AngrySaltyFish24/ServerController/README.md

# ServerController

This project allows for a server to be remotely turned on and off using a particle photon board along with a series of relays.
