AngrySaltyFish24/ServerController/EPQ – Artefact.pptx

## EPQ – Artefact Server Controller

By James Rand

## The main aim of the project

- File server that is used to store work
- Sever cannot always be on.
- I always want to have access to the server.
- Build a device that can remotely turn on and off the server.

## Checklist

- Be able to turn the server on and off
- Be power efficient to avoid cost
- Forward a shell to the server
- Have an interface to perform all of the tasks above
- Do not exceed the budget of £50.00

## Choosing the components

- Need a development board that can connect to WiFi
  - Raspberry pi
  - Photon
- Electronic switches that can be controlled by the board
  - Relays
  - Transistors

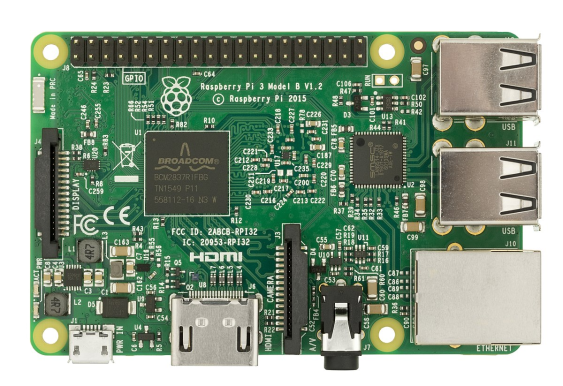
[picture p23: figure]
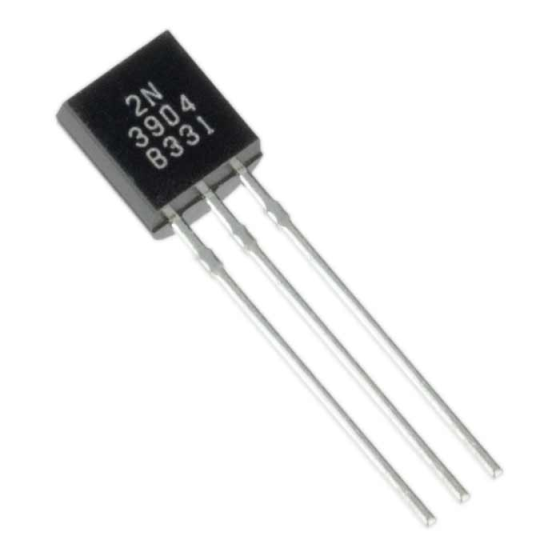
[picture p24: figure]
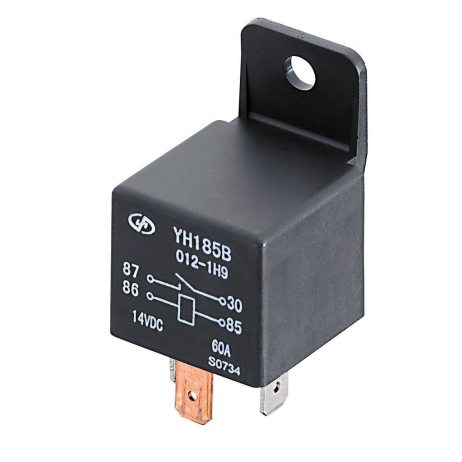
[picture p25: figure]

## The particle photon

- Pros
  - Relatively cheap
  - Has extensive api to help program
  - Draws little power
  - Good documentation
- Cons
  - Does not have an OS to interact with
  - Limited functionality

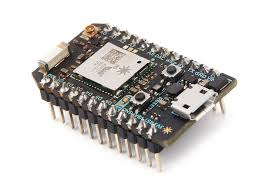
[picture p26: figure]

## Relay board

- Pros
  - Can handle high voltages with ease
  - Detachable
  - Easy to use
  - Expandable
- Cons
  - Expensive

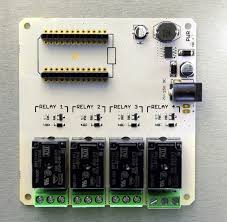
[picture p27: figure]

## Design for turning on the server

These wires go to the
Particle photon

Relay

## Stopping standby to save more power

Wires to controller

## Adding a override switch

- Decided to add a switch
- Stops any attempts to turn
on the server

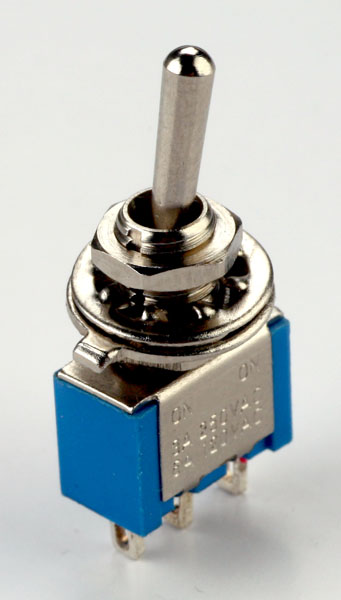
[picture p28: figure]

## An interesting Quirk

- Usb port is only powered when the server is on
- Use this power to turn off the controller using another relay

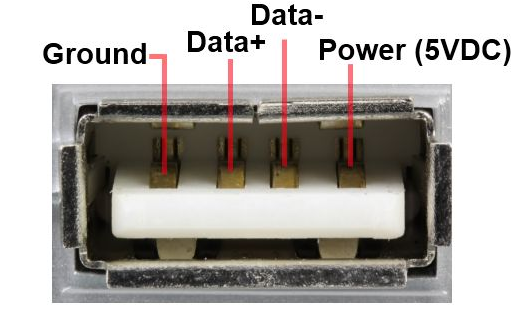
[picture p29: figure]

## Code

- An interface in python
- Code on the controller written in C
- Also using the api for the controller code

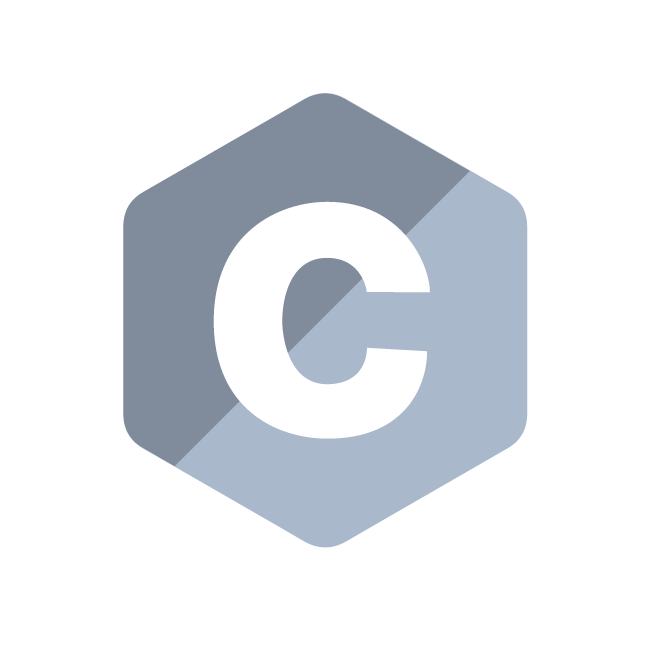
[picture p30: figure]
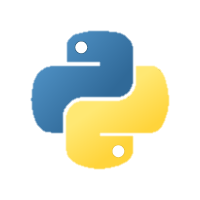
[picture p31: figure]

## Controller code

- Saves the ip address
- Activates the relays

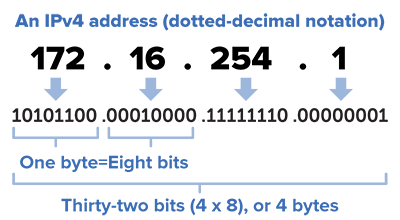
[picture p32: figure]
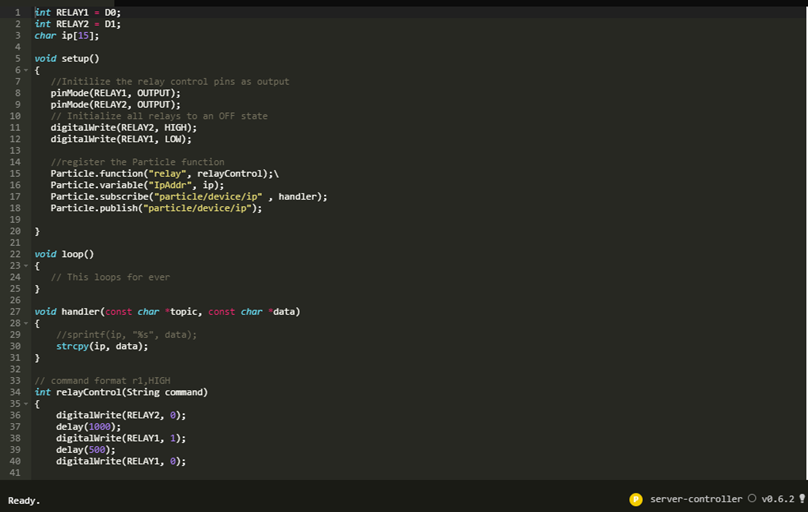
[picture p33: figure]

## Python interface

- Send the request to turn on the server
- Get the ip address from controller
- Use that ip address to open ssh connection

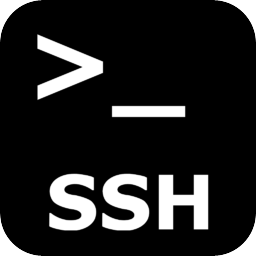
[picture p34: figure]
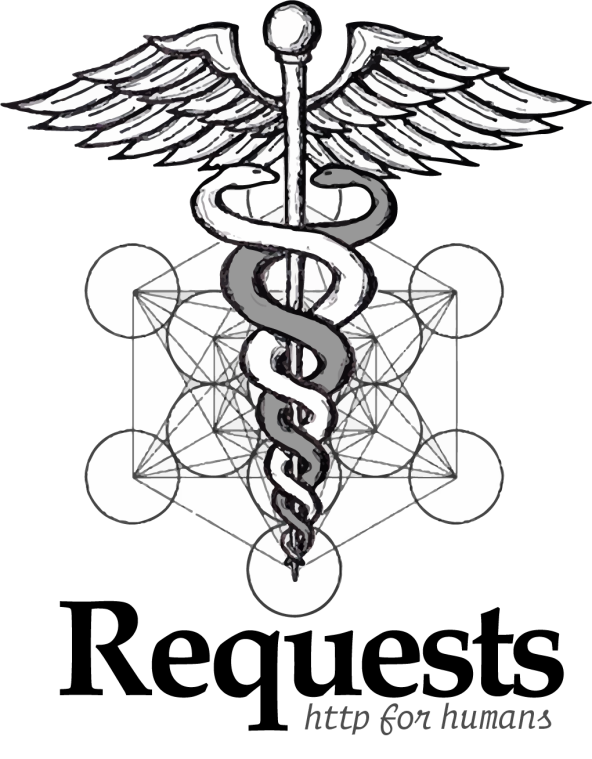
[picture p35: figure]

## Putting it all together

- Processes used
  - Soldering
- Materials used
  - solder
  - Electrical tape

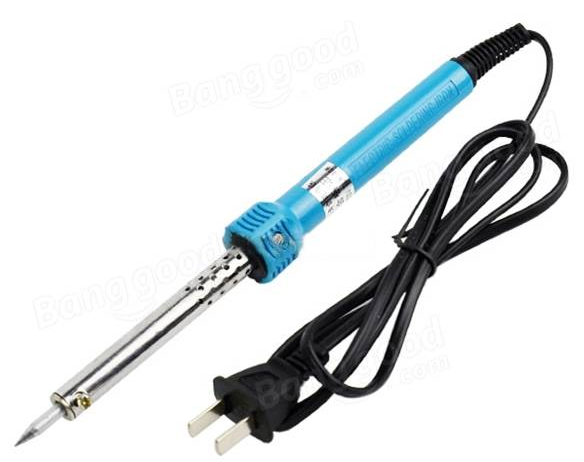
[picture p36: figure]
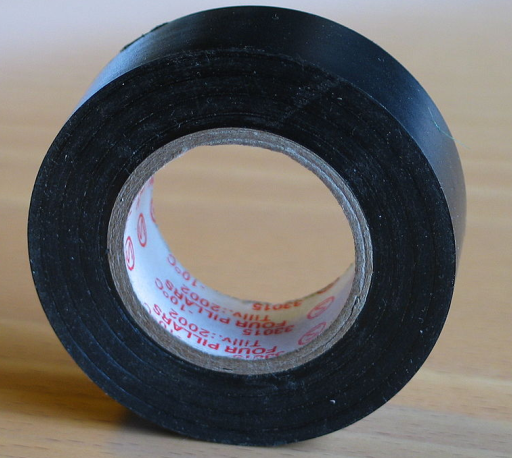
[picture p37: figure]
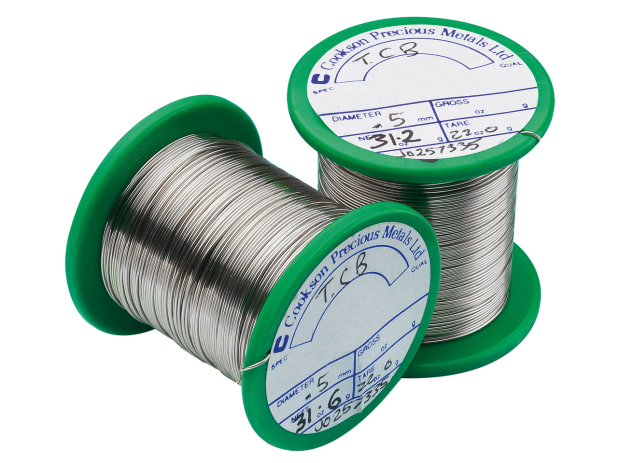
[picture p38: figure]

## Evaluation

- What went well
  - Turns on the server
  - Uses very little power
- What went poorly
  - The python interface is buggy and unstable
    - This could be improve without time constraints
    - Could have ported the interface to a bot so many users could interact with it

## What I’ve Learnt

- Learnt about different electronic components and how they work
