AngrySaltyFish24/ServerController/docs/pictures/camera/externalRelayTest.jpg

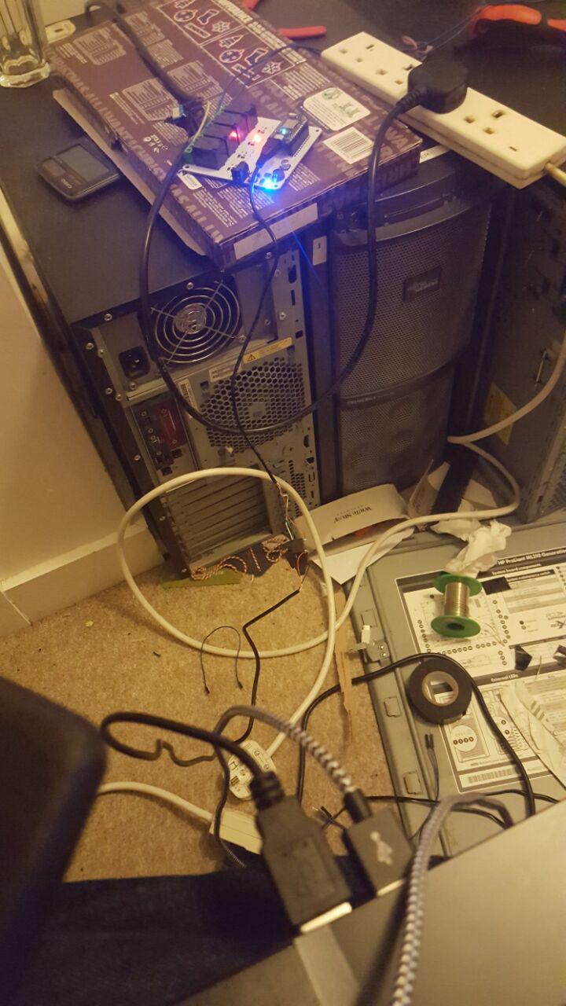
docs/pictures/camera/externalRelayTest.jpg
