AngrySaltyFish24/ServerController/docs/pictures/transistorTest.PNG

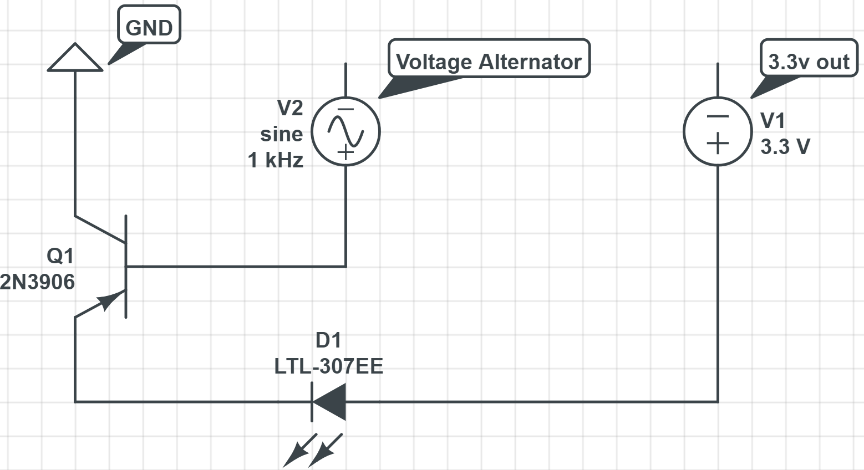
docs/pictures/transistorTest.PNG
