AngrySaltyFish24/ServerController/src/boardCcode/relaytest.ino

int RELAY1 = D0;
int RELAY2 = D1;
int RELAY3 = D2;
int RELAY4 = D3;

int relayState = 0;


void setup()
{
   //Initilize the relay control pins as output
   pinMode(RELAY1, OUTPUT);
   pinMode(RELAY2, OUTPUT);
   pinMode(RELAY3, OUTPUT);
   pinMode(RELAY4, OUTPUT);
   // Initialize all relays to an OFF state
   digitalWrite(RELAY1, LOW);
   digitalWrite(RELAY2, LOW);
   digitalWrite(RELAY3, LOW);
   digitalWrite(RELAY4, LOW);

   //register the Particle function
   Particle.function("relay", relayControl);
}

void loop()
{
   // This loops for ever
}

// command format r1,HIGH
int relayControl(String command)
{
    relayState = !relayState;
  // parse the relay number
 

  // write to the appropriate relay
  digitalWrite(0, relayState);
  return 1;
}
