AngrySaltyFish24/ServerController/docs/pictures/camera/solderIron.jpg

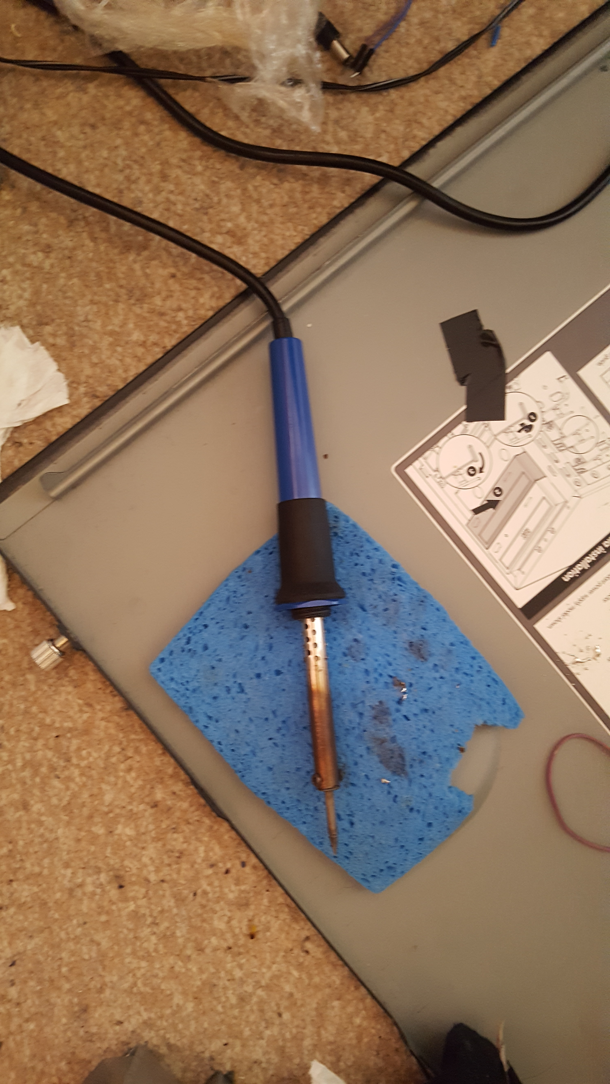
[picture p7: docs/pictures/camera/solderIron.jpg]
docs/pictures/camera/solderIron.jpg
