AngrySaltyFish24/ServerController/docs/pictures/camera/tapedServerWire.jpg

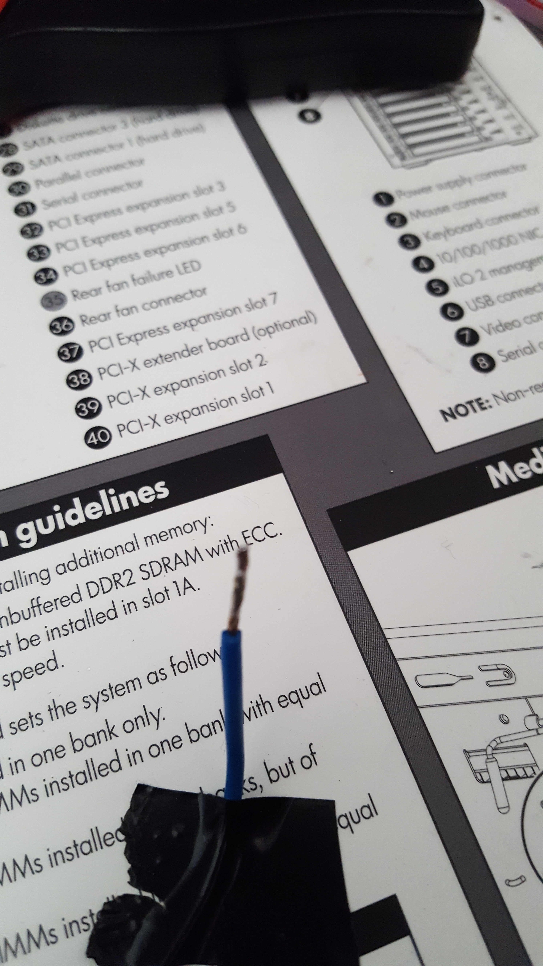
[picture p9: docs/pictures/camera/tapedServerWire.jpg]
docs/pictures/camera/tapedServerWire.jpg
