AngrySaltyFish24/ServerController/docs/pictures/camera/solderServerWiresNewest.jpg

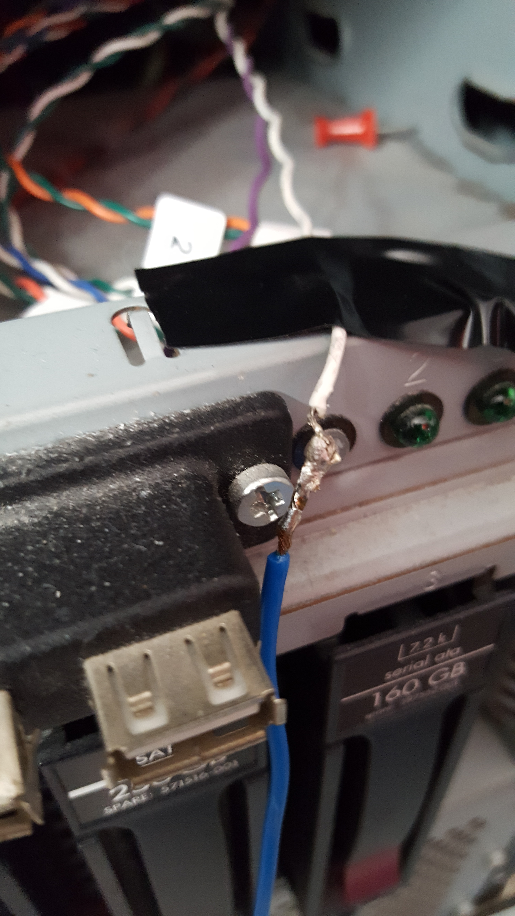
[picture p10: docs/pictures/camera/solderServerWiresNewest.jpg]
docs/pictures/camera/solderServerWiresNewest.jpg
