AngrySaltyFish24/ServerController/docs/pictures/camera/serverWiresConnectedAndInuslated.jpg

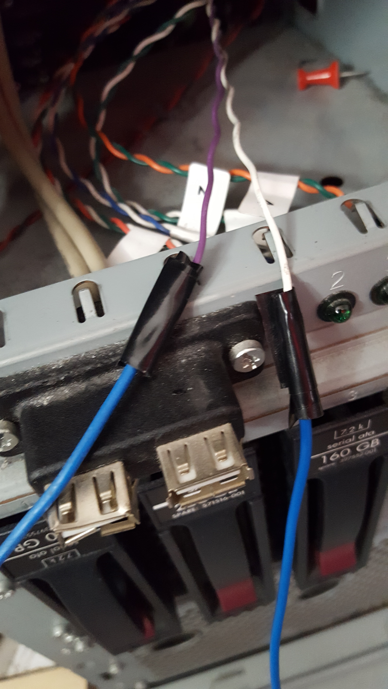
[picture p11: docs/pictures/camera/serverWiresConnectedAndInuslated.jpg]
docs/pictures/camera/serverWiresConnectedAndInuslated.jpg
