AngrySaltyFish24/ServerController/docs/pictures/camera/outGoingWiresToRelay.jpg

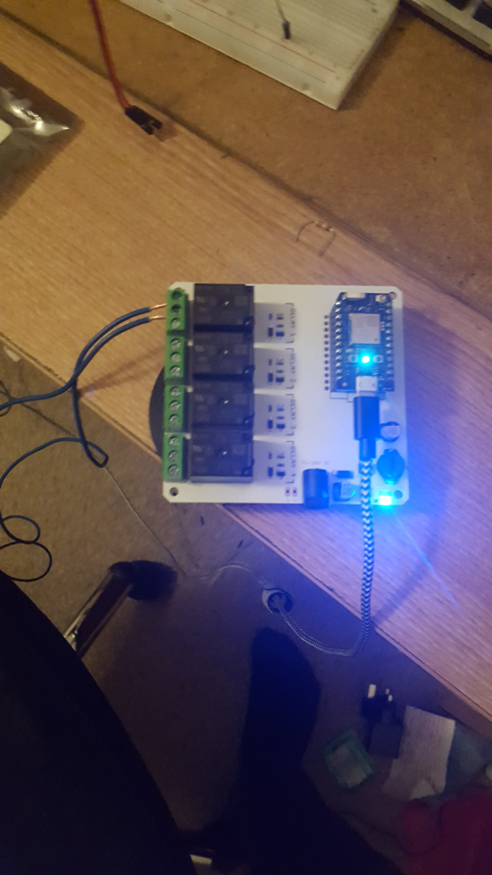
[picture p12: docs/pictures/camera/outGoingWiresToRelay.jpg]
docs/pictures/camera/outGoingWiresToRelay.jpg
