AngrySaltyFish24/ServerController/docs/pictures/camera/removeOuterInsulationMainsWire.jpg

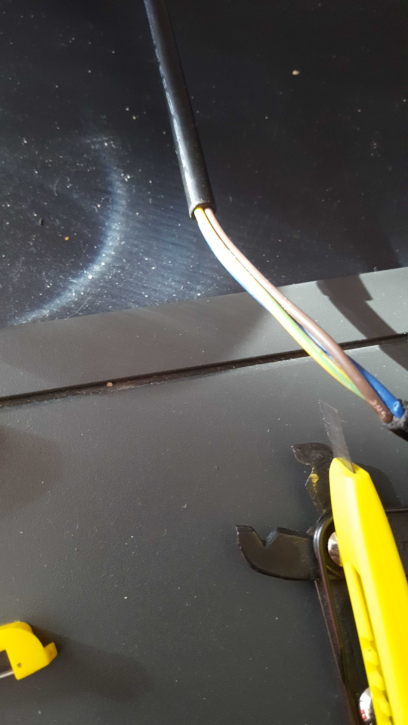
[picture p13: docs/pictures/camera/removeOuterInsulationMainsWire.jpg]
docs/pictures/camera/removeOuterInsulationMainsWire.jpg
