AngrySaltyFish24/ServerController/docs/pictures/camera/docs/20180118_134737.jpg

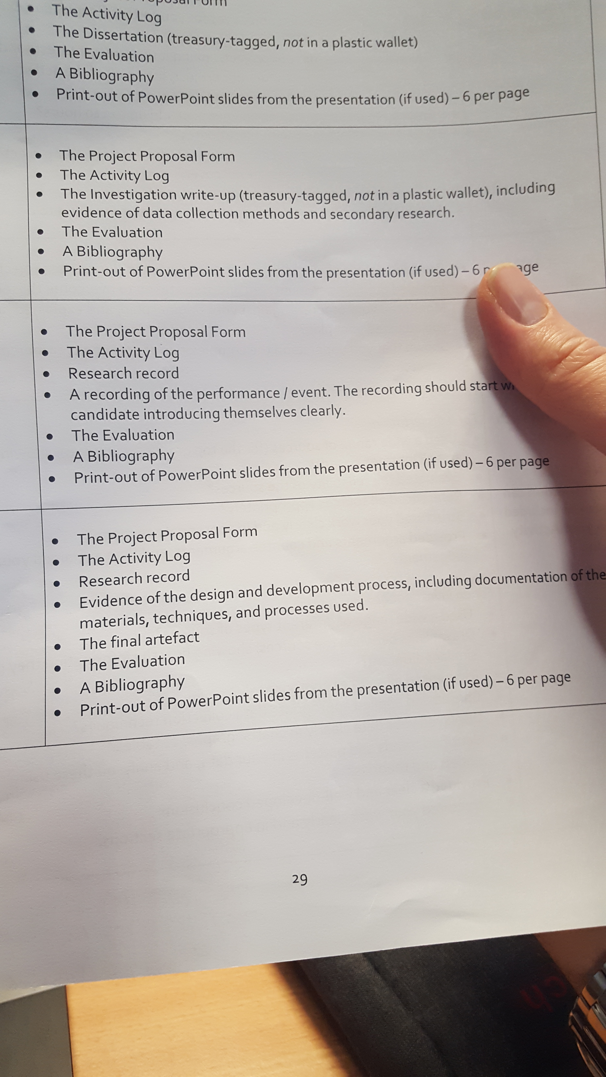
docs/pictures/camera/docs/20180118_134737.jpg
