AngrySaltyFish24/ServerController/docs/pictures/camera/docs/20180118_135128.jpg

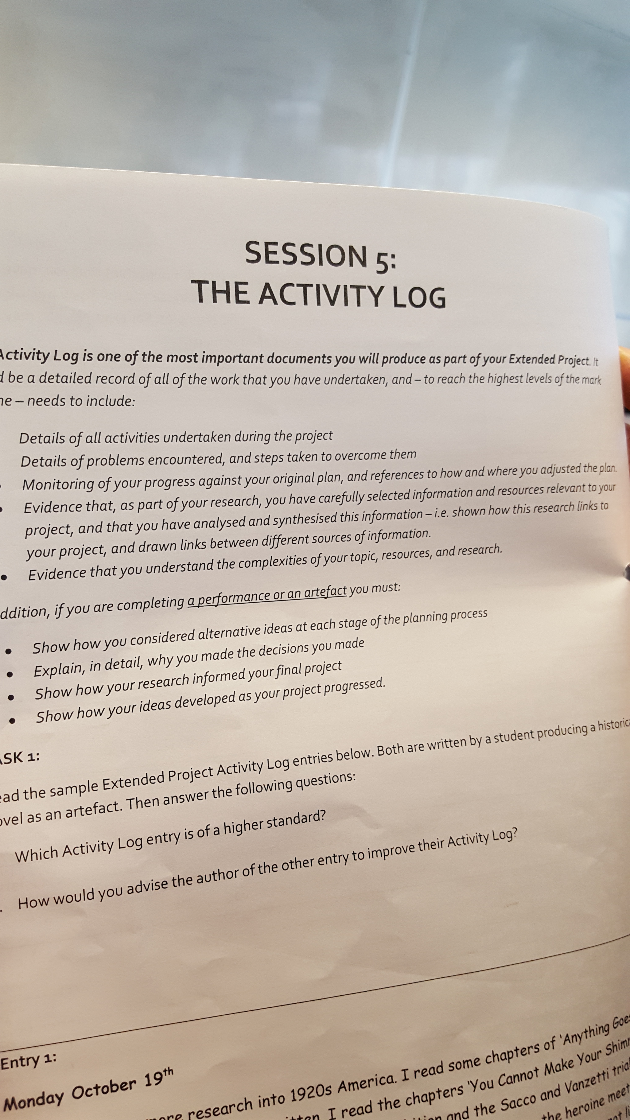
docs/pictures/camera/docs/20180118_135128.jpg
