AngrySaltyFish24/ServerController/docs/pictures/camera/relayTest.jpg

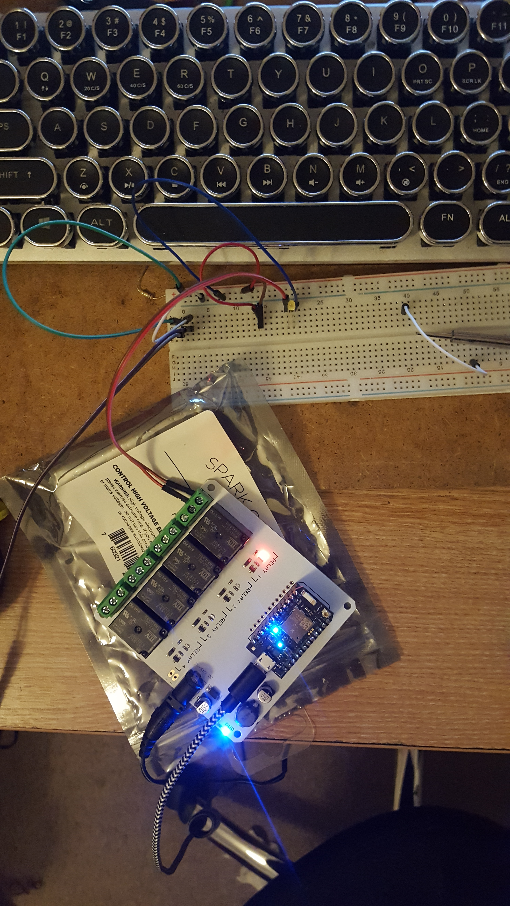
docs/pictures/camera/relayTest.jpg
